sidirima/esp32_env_data_acquisistion_system/Altium_PCB_Design/3D_view.png

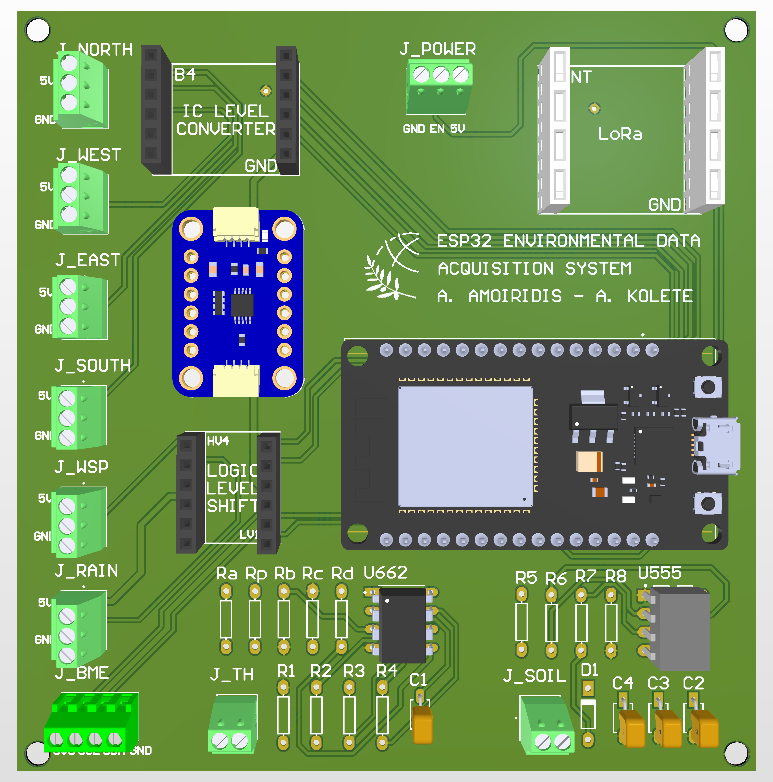
Altium_PCB_Design/3D_view.png
