sidirima/esp32_env_data_acquisistion_system/Altium_PCB_Design/Bottom_layer_view.png

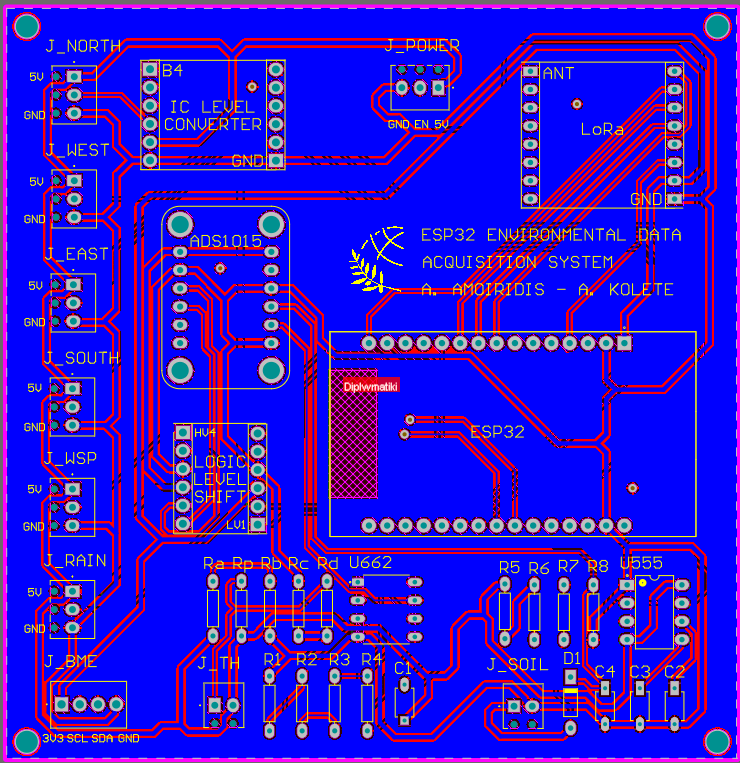
Altium_PCB_Design/Bottom_layer_view.png
