sidirima/esp32_env_data_acquisistion_system/Block_Diagrams/Power_supply.png

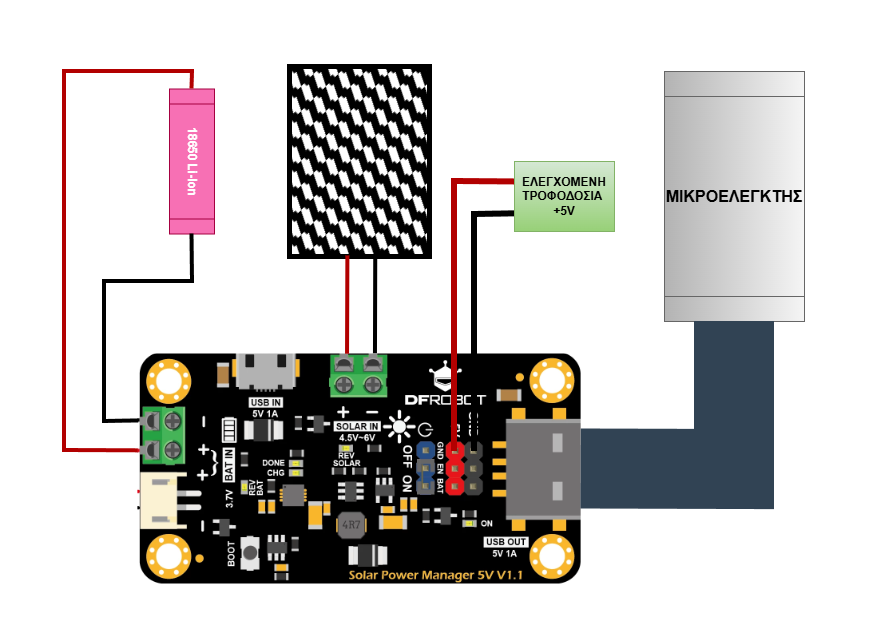
Block_Diagrams/Power_supply.png
