sidirima/esp32_env_data_acquisistion_system/Block_Diagrams/Receiver.png

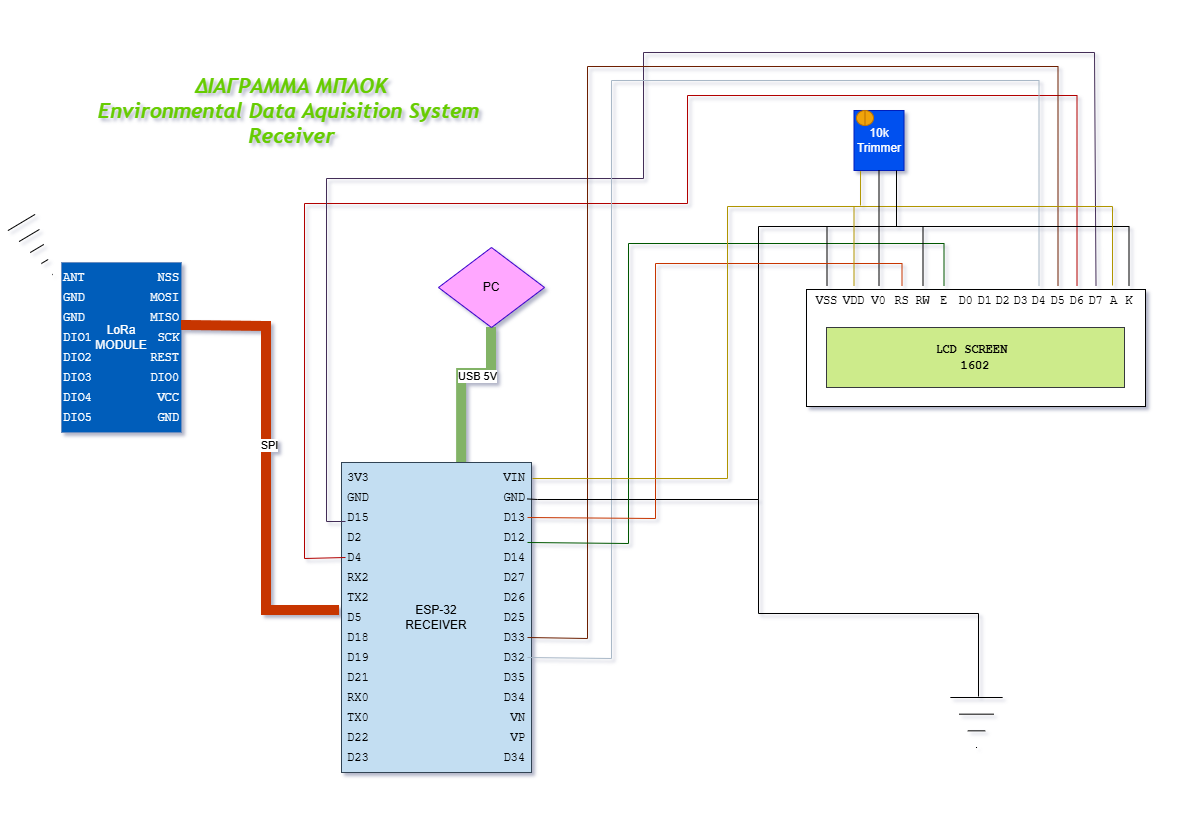
Block_Diagrams/Receiver.png
