sidirima/esp32_env_data_acquisistion_system/Block_Diagrams/Transmitter.png

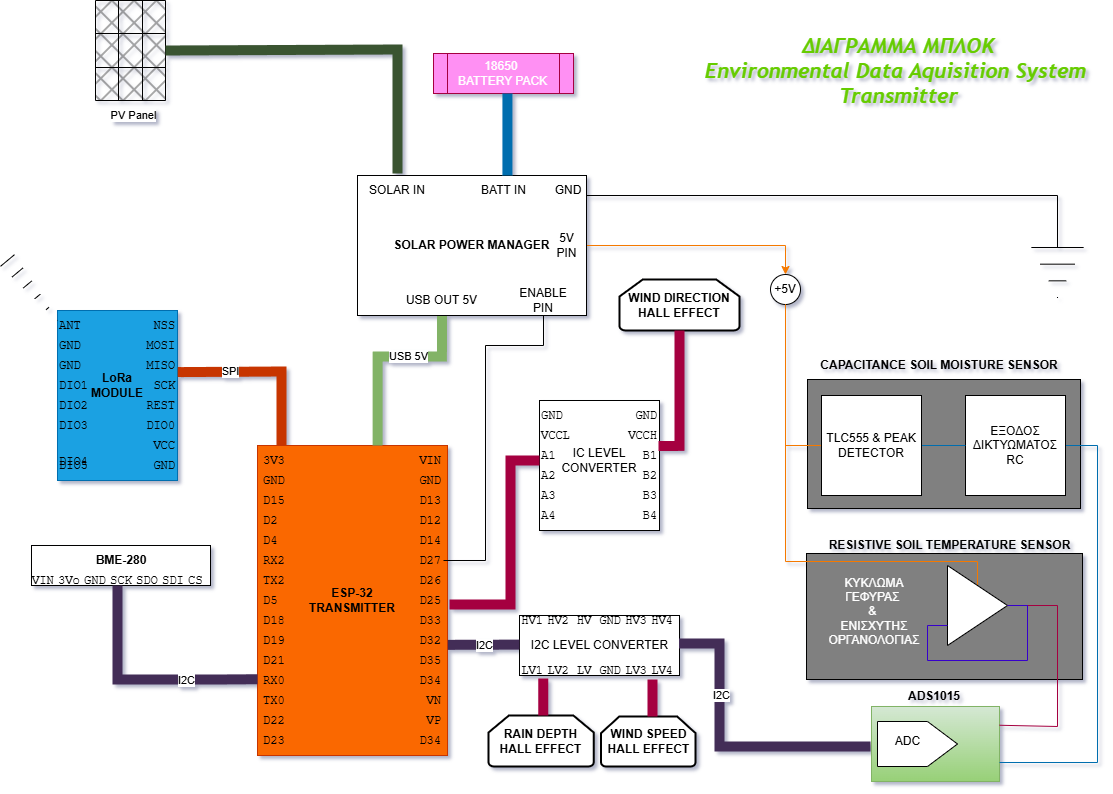
Block_Diagrams/Transmitter.png
