sidirima/esp32_env_data_acquisistion_system/Final_Product_Photos/ESP32_Receiver_boxed.jpg

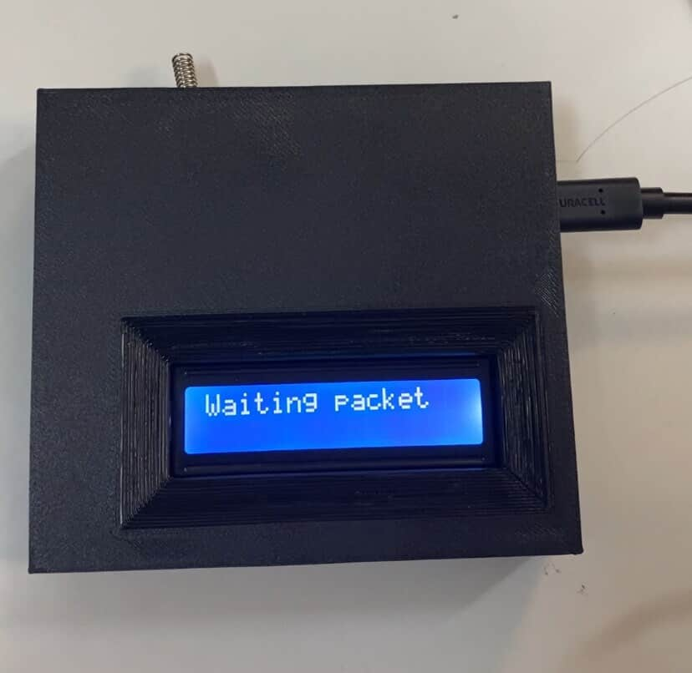
Final_Product_Photos/ESP32_Receiver_boxed.jpg
