sidirima/esp32_env_data_acquisistion_system/Final_Product_Photos/Transmitter.png

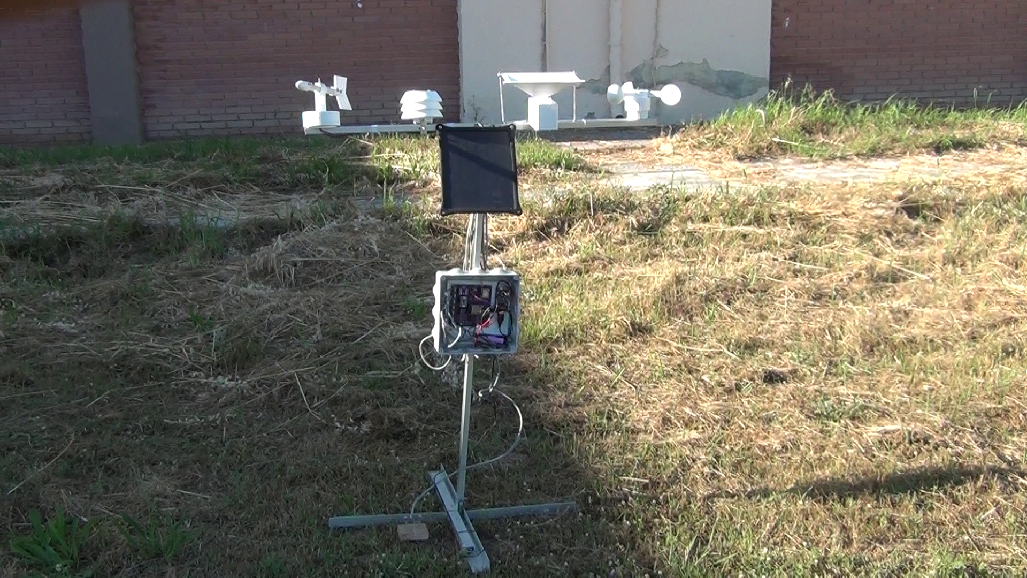
Final_Product_Photos/Transmitter.png
