sidirima/esp32_env_data_acquisistion_system/Schematics/ESP32_Env_Data_Acq_Receiver.png

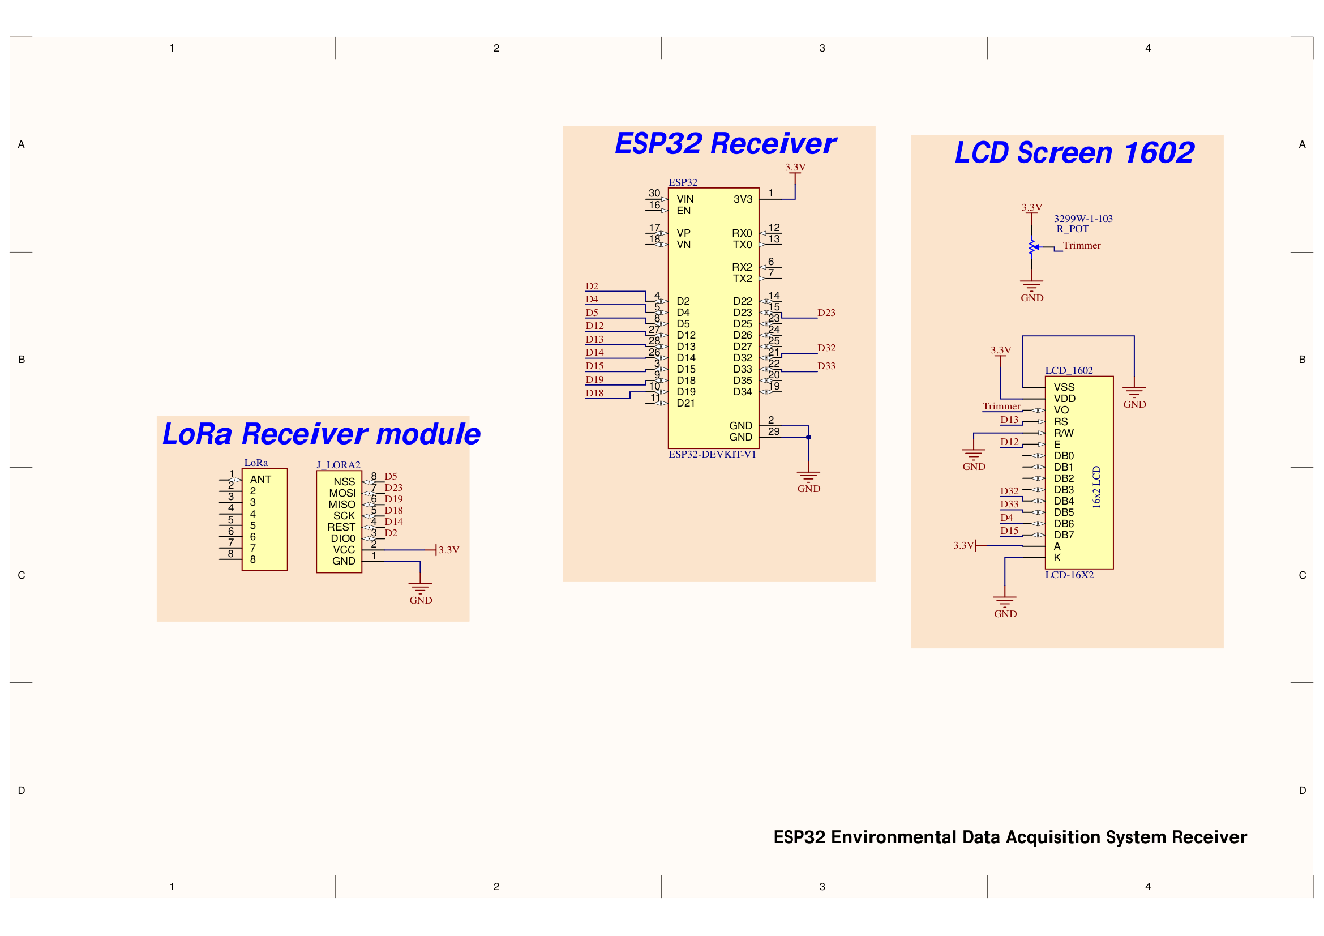
Schematics/ESP32_Env_Data_Acq_Receiver.png
