sidirima/esp32_env_data_acquisistion_system/(commit log)

2026-10-09 Rename Διάγραμμα Μπλοκ Transmitter New.png to Block_Diagrams/Transmitter.png
2026-10-09 Rename ESP32 receiver_unboxed.jpg to Final_Product_Photos/ESP32_receiver_unboxed.jpg
2026-10-09 Rename Ωμικό Αισθητήριο Θερμοκρασίας.png to Ωμικό Αισθητήριο Θερμοκρασίας.jpg
2026-10-09 Rename Ωμικό Αισθητήριο Θερμοκρασίας.jpg to Ωμικό Αισθητήριο Θερμοκρασίας.png
2026-10-15 Rename Project Outputs for Diplwmatiki.rar to Gerber_files.rar
