sidirima/esp32_env_data_acquisistion_system/Final_Product_Photos/Transmitter_PCB_Assembled.jpg

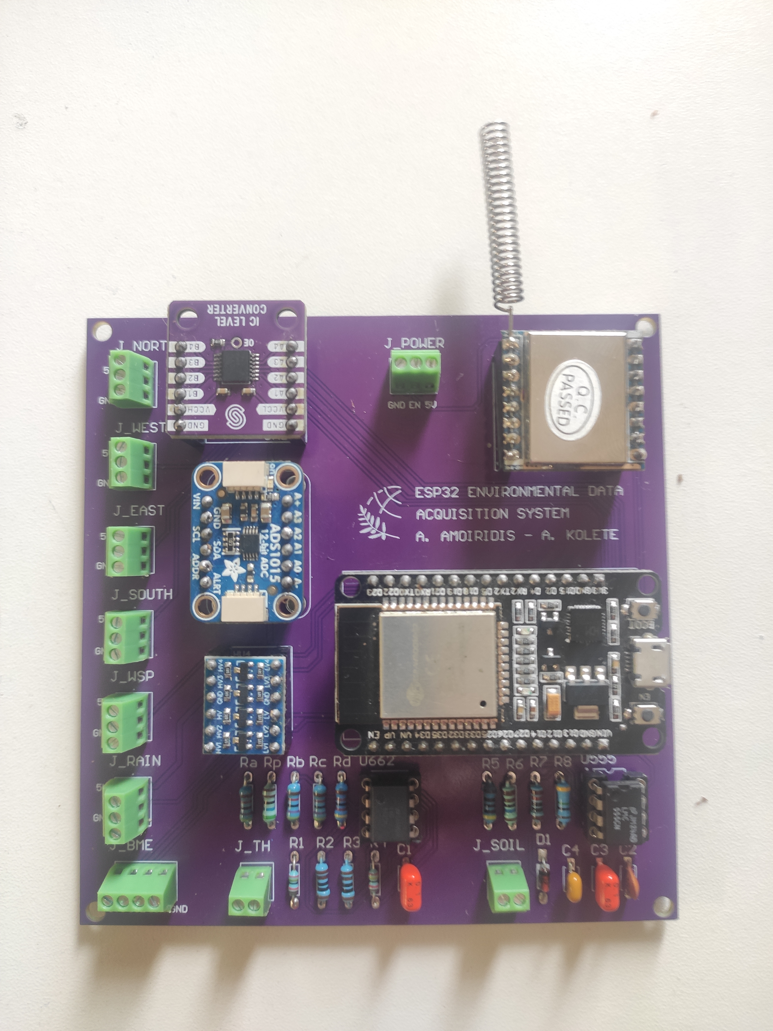
Final_Product_Photos/Transmitter_PCB_Assembled.jpg
